liuzikai/wireless-charging-table/extra/JetsonNano-expansion-pinout.png

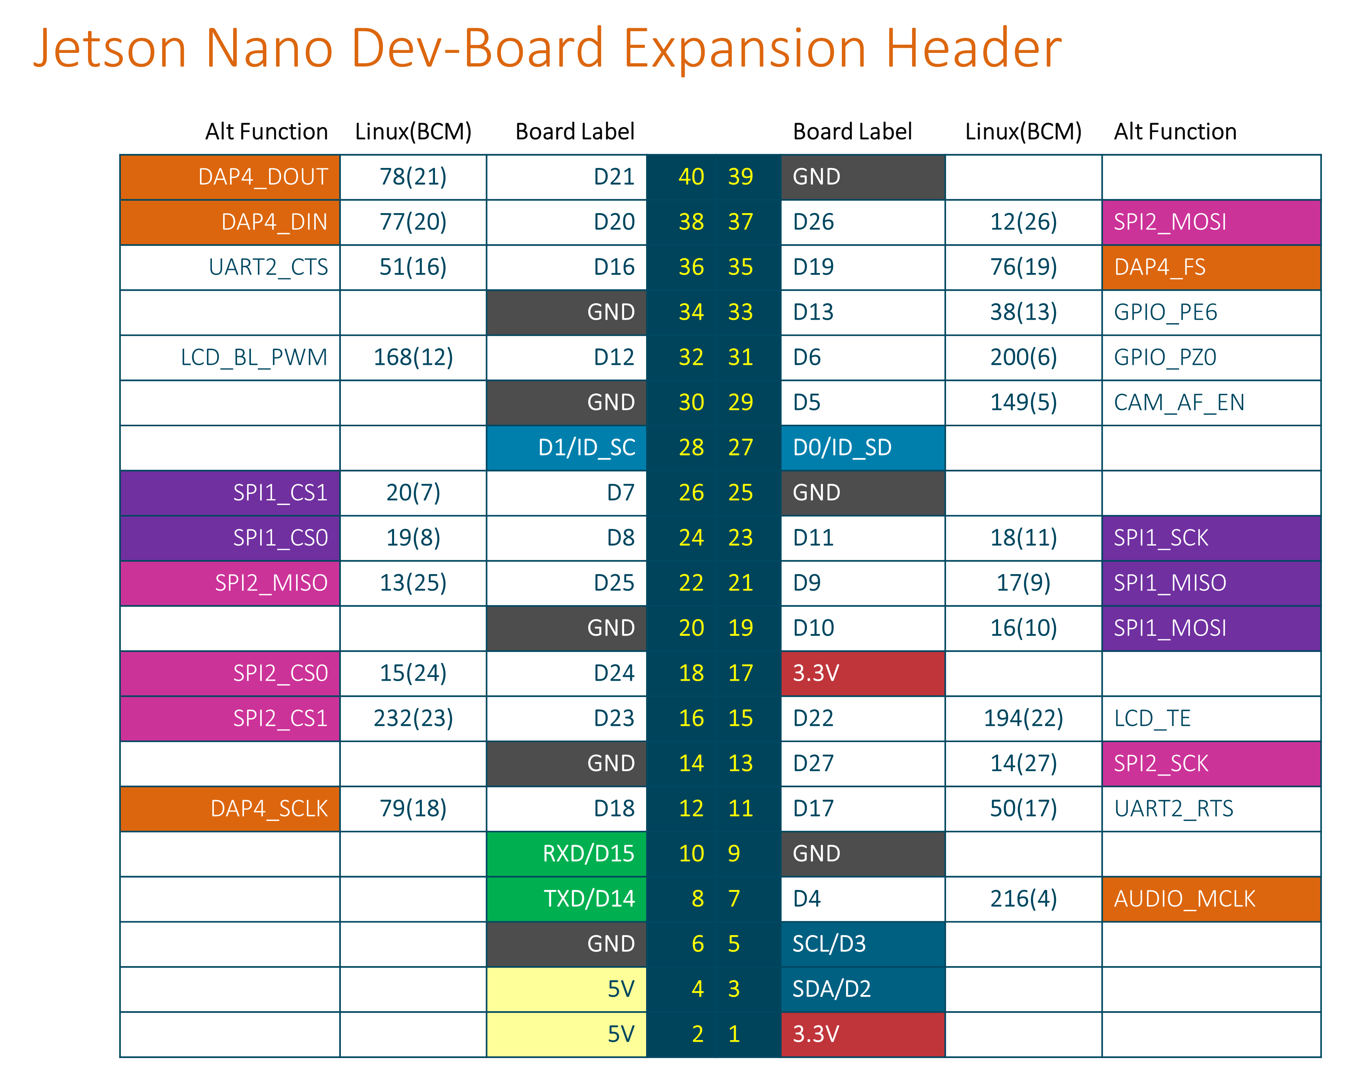
extra/JetsonNano-expansion-pinout.png
