liuzikai/wireless-charging-table/model/V1.0/Tensioner B-26^Tensioner B_Front Idler B_Gantry_VORON2 v2.4 Assembly - Final(2)_VORON2 v2.4 Assembly - Final.SLDPRT

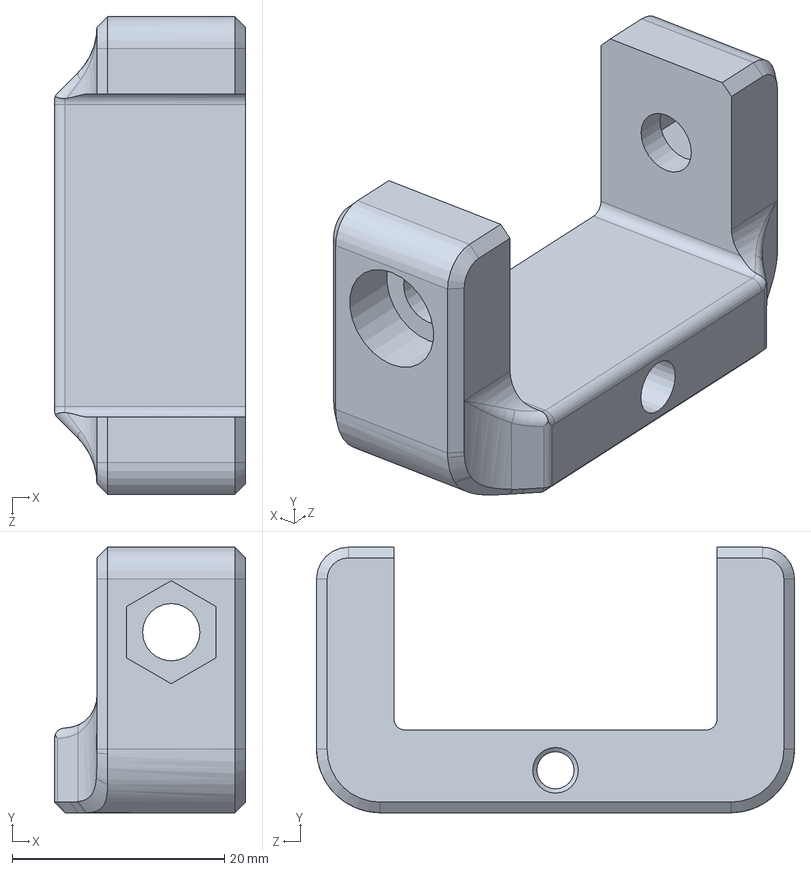
[picture p20: CAD file, 2022-02-23]
model/V1.0/Tensioner B-26^Tensioner B_Front Idler B_Gantry_VORON2 v2.4 Assembly - Final(2)_VORON2 v2.4 Assembly - Final.SLDPRT
18.0 x 25.0 x 45.0 mm
