liuzikai/wireless-charging-table/model/V1.0/NEMA17Thin.SLDASM

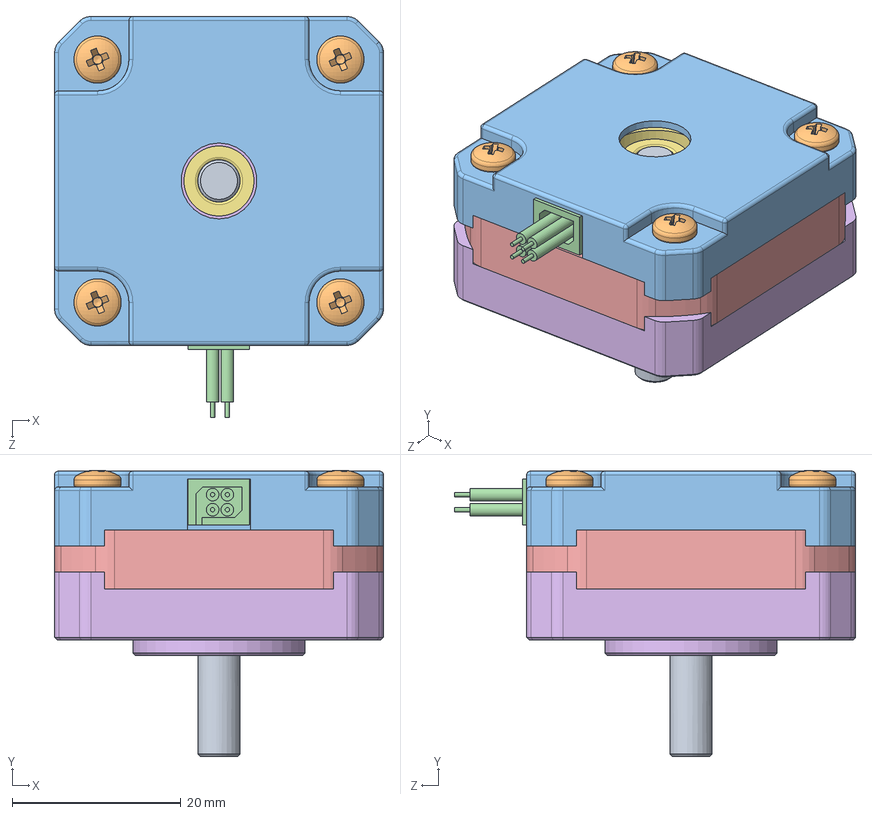
[picture p21: CAD file, 2022-02-23]
model/V1.0/NEMA17Thin.SLDASM
39.0 x 34.0 x 47.5 mm
41ME3991AL_Shaft.stp
M3 Screw.stp x 4
41ME3991AL_Back.stp
41ME3991AL_Cable.stp
41ME3991AL_Middle.stp
41ME3991AL_Front.stp
41ME3991AL_Roller.stp
