liuzikai/wireless-charging-table/model/V1.0/MGN9-390.SLDASM

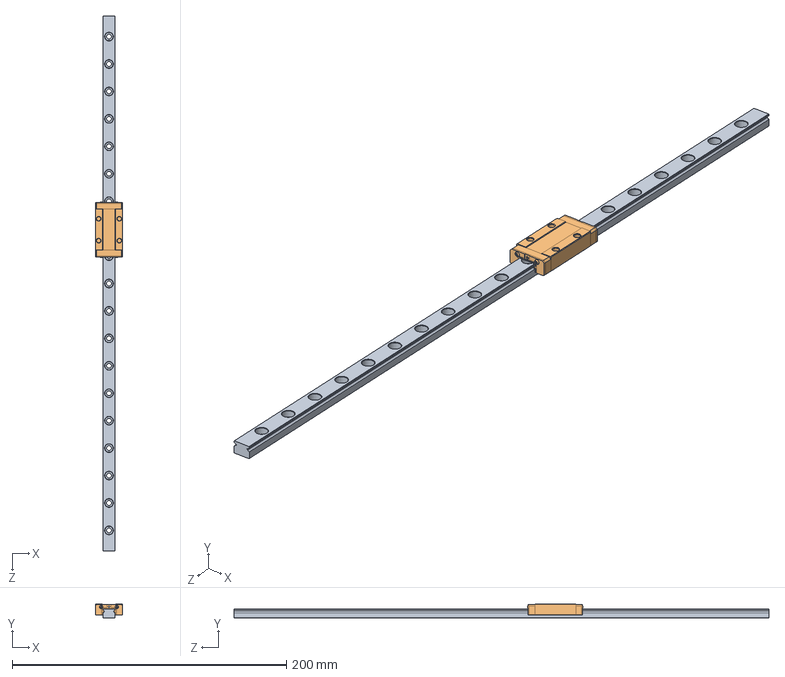
[picture p22: CAD file, 2022-02-23]
model/V1.0/MGN9-390.SLDASM
20.0 x 10.0 x 390.0 mm
MGN9
MGN9-H
