liuzikai/wireless-charging-table/model/V1.0/MGN9H.SLDASM

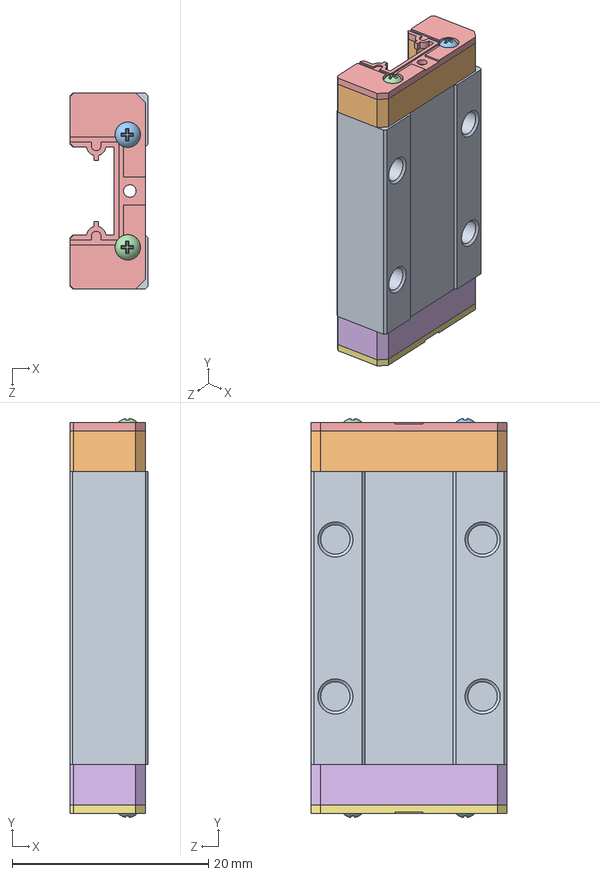
[picture p25: CAD file, 2022-02-23]
model/V1.0/MGN9H.SLDASM
8.00 x 40.7 x 20.0 mm
MGN9H - Carriage (9)^MGN9H
MGN9H - Carriage (1) (1)^MGN9H
MGN9H - Carriage (2) (1)^MGN9H
MGN9H - Carriage (3) (1)^MGN9H
MGN9H - Carriage (4) (1)^MGN9H
MGN9H - Carriage (5) (1)^MGN9H
MGN9H - Carriage (6) (1)^MGN9H
MGN9H - Carriage (7) (1)^MGN9H
MGN9H - Carriage (8) (1)^MGN9H
