liuzikai/wireless-charging-table/model/V1.0/XY Cable Chain Bridge - IGUS-58^XY Cable Chain Bridge - IGUS_XY Joint - Right_X Axis_Gantry_VORON2 v2.4 Assembly - Final(2)_VORON2 v2.4 Assembly - Final.SLDPRT

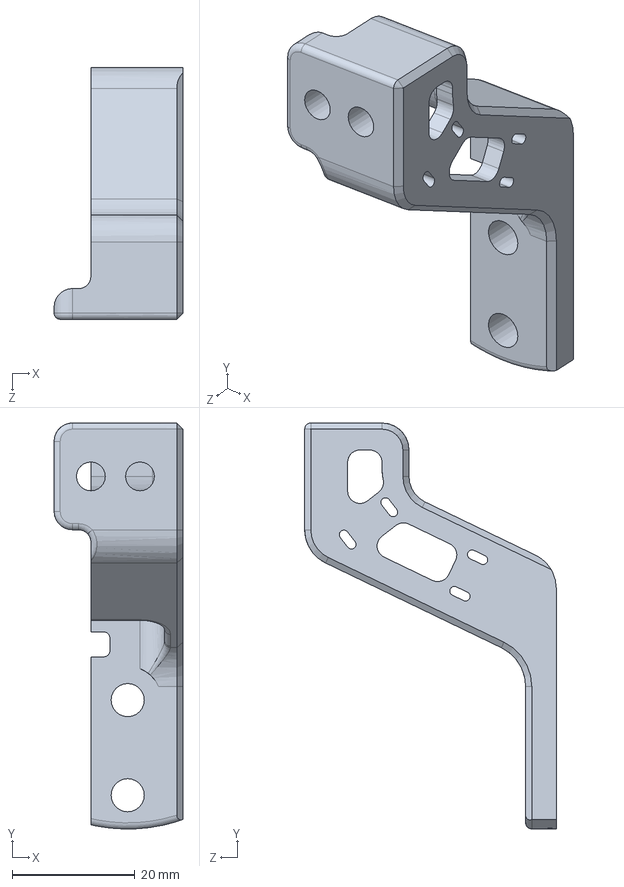
[picture p26: CAD file, 2022-02-23]
model/V1.0/XY Cable Chain Bridge - IGUS-58^XY Cable Chain Bridge - IGUS_XY Joint - Right_X Axis_Gantry_VORON2 v2.4 Assembly - Final(2)_VORON2 v2.4 Assembly - Final.SLDPRT
21.0 x 66.1 x 41.0 mm
