liuzikai/wireless-charging-table/model/V1.0/MGN12AssemXaxis.SLDASM

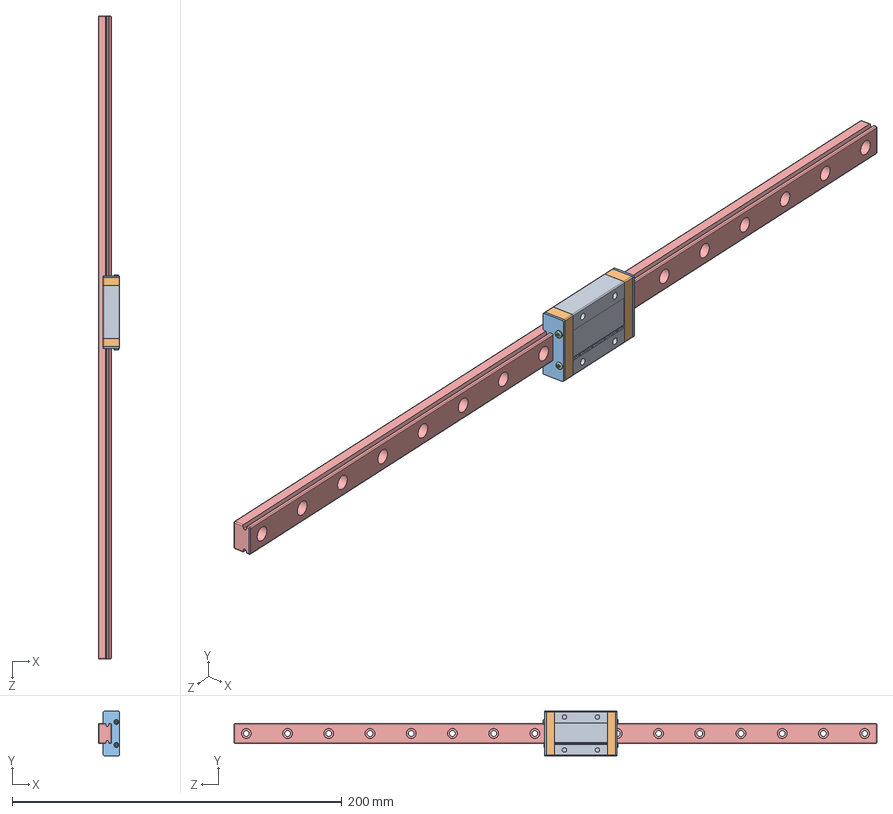
[picture p28: CAD file, 2022-02-23]
model/V1.0/MGN12AssemXaxis.SLDASM
13.0 x 27.0 x 390.0 mm
Main Block
Green End Cap x 2
Red End Cap x 2
Button M3x8 x 4
Rail 3850mm
