liuzikai/wireless-charging-table/model/V1.0/X Carriage Frame-35^X Carriage Frame_X Carriage_X Axis_Gantry_VORON2 v2.4 Assembly - Final(2)_VORON2 v2.4 Assembly - Final.SLDPRT

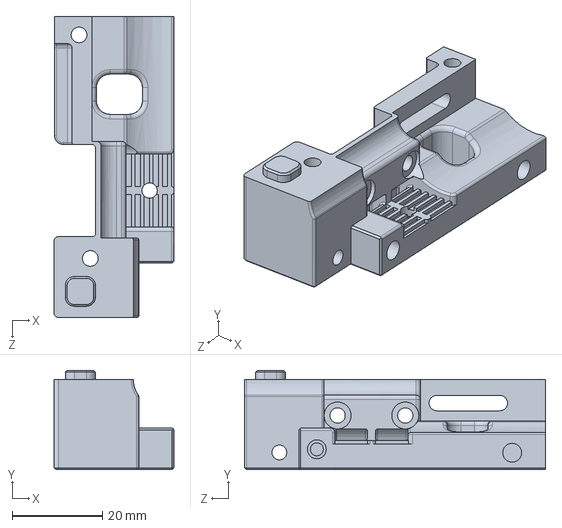
[picture p29: CAD file, 2022-02-23]
model/V1.0/X Carriage Frame-35^X Carriage Frame_X Carriage_X Axis_Gantry_VORON2 v2.4 Assembly - Final(2)_VORON2 v2.4 Assembly - Final.SLDPRT
26.6 x 22.0 x 66.8 mm
