liuzikai/wireless-charging-table/model/V1.0/Front Idler B Top^Front Idler B_Gantry_VORON2 v2.4 Assembly - Final(2)_VORON2 v2.4 Assembly - Final.SLDPRT

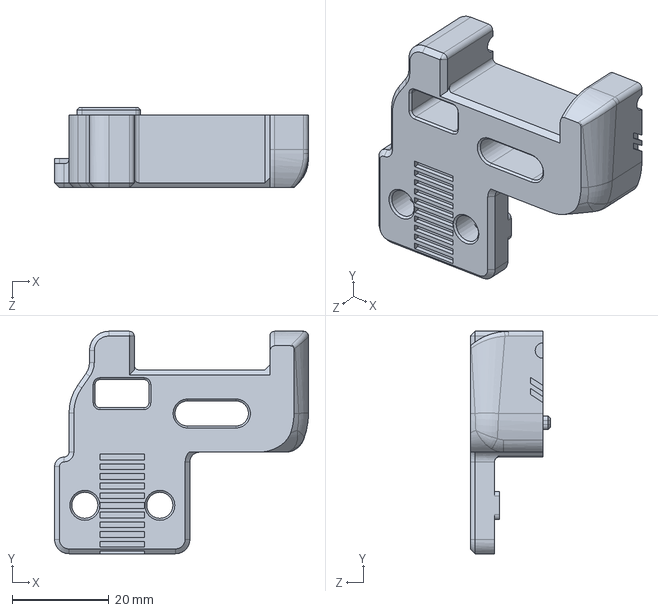
[picture p30: CAD file, 2022-02-23]
model/V1.0/Front Idler B Top^Front Idler B_Gantry_VORON2 v2.4 Assembly - Final(2)_VORON2 v2.4 Assembly - Final.SLDPRT
52.5 x 46.0 x 16.6 mm
