liuzikai/wireless-charging-table/model/V1.0/MGN9-120.SLDASM

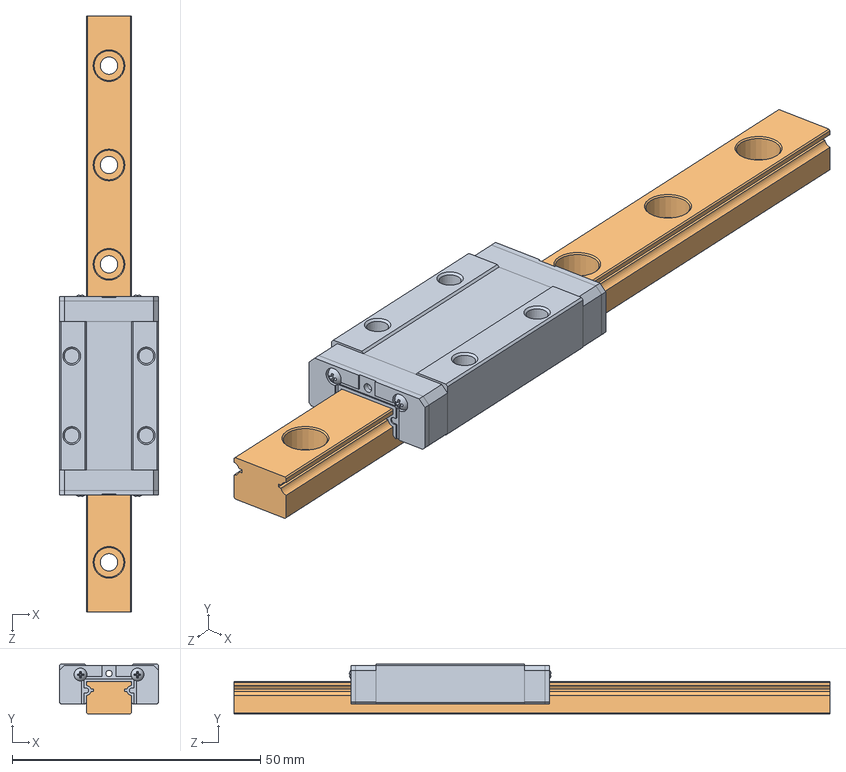
[picture p31: CAD file, 2022-02-23]
model/V1.0/MGN9-120.SLDASM
20.0 x 10.0 x 120.0 mm
MGN9-H
MGN9-120
