liuzikai/wireless-charging-table/model/V1.0/A Drive Frame-24^A Drive Frame_A Drive_Gantry_VORON2 v2.4 Assembly - Final(2)_VORON2 v2.4 Assembly - Final.SLDPRT

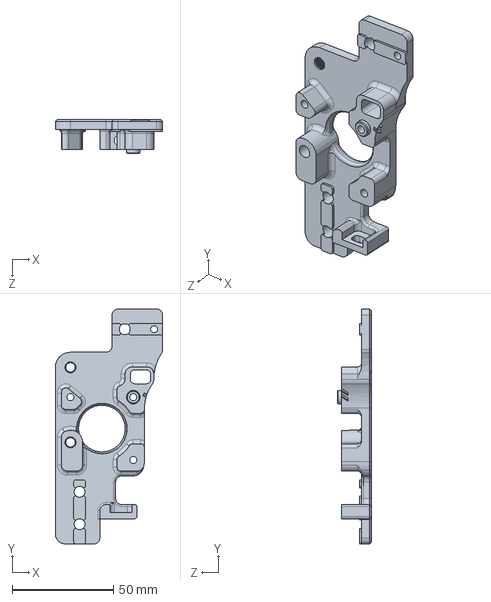
[picture p32: CAD file, 2022-02-23]
model/V1.0/A Drive Frame-24^A Drive Frame_A Drive_Gantry_VORON2 v2.4 Assembly - Final(2)_VORON2 v2.4 Assembly - Final.SLDPRT
53.0 x 116.0 x 17.0 mm
