liuzikai/wireless-charging-table/model/V1.0/XY Joint - Right-63^XY Joint - Right_X Axis_Gantry_VORON2 v2.4 Assembly - Final(2)_VORON2 v2.4 Assembly - Final.SLDPRT

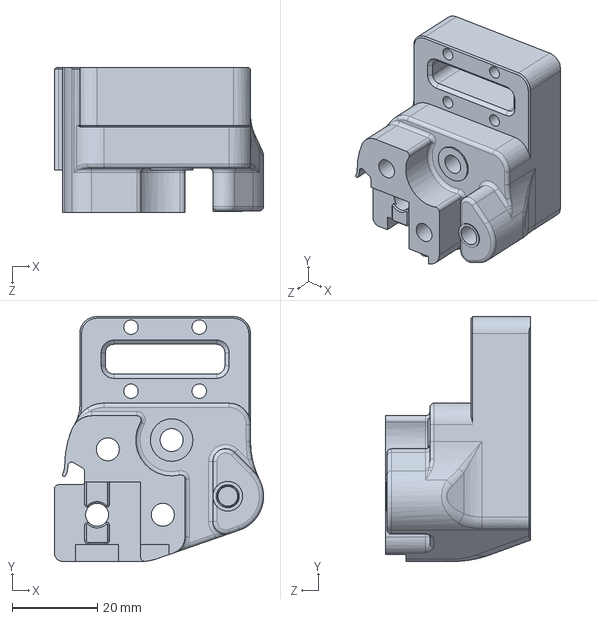
[picture p34: CAD file, 2022-02-23]
model/V1.0/XY Joint - Right-63^XY Joint - Right_X Axis_Gantry_VORON2 v2.4 Assembly - Final(2)_VORON2 v2.4 Assembly - Final.SLDPRT
49.0 x 57.4 x 34.0 mm
