liuzikai/wireless-charging-table/model/V1.0/cable cover^A Drive_Gantry_VORON2 v2.4 Assembly - Final(2)_VORON2 v2.4 Assembly - Final.SLDPRT

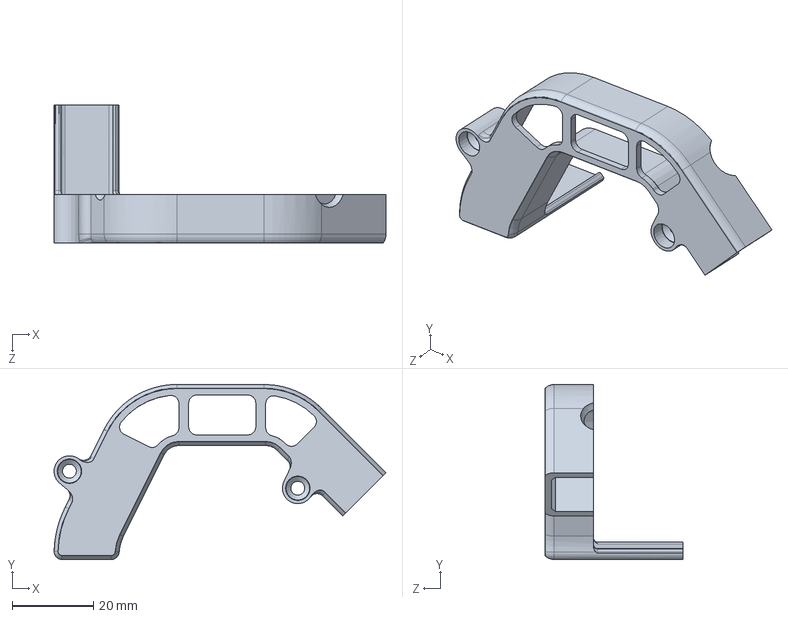
[picture p35: CAD file, 2022-02-23]
model/V1.0/cable cover^A Drive_Gantry_VORON2 v2.4 Assembly - Final(2)_VORON2 v2.4 Assembly - Final.SLDPRT
81.5 x 43.0 x 34.0 mm
