liuzikai/wireless-charging-table/model/V1.0/B Drive Frame (1)^B Drive_Gantry_VORON2 v2.4 Assembly - Final(2)_VORON2 v2.4 Assembly - Final.SLDPRT

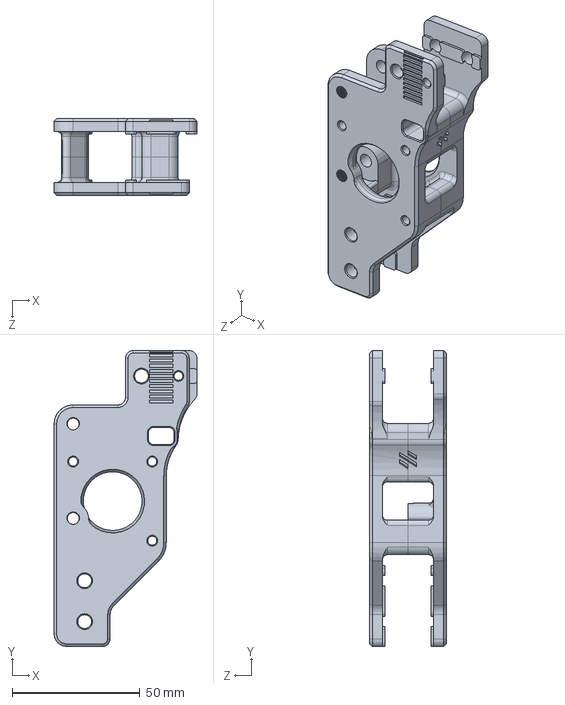
[picture p36: CAD file, 2022-02-23]
model/V1.0/B Drive Frame (1)^B Drive_Gantry_VORON2 v2.4 Assembly - Final(2)_VORON2 v2.4 Assembly - Final.SLDPRT
56.0 x 116.0 x 30.0 mm
