liuzikai/wireless-charging-table/model/V1.0/Belt Clamp_1-34^Belt Clamp_1_X Carriage Frame_X Carriage_X Axis_Gantry_VORON2 v2.4 Assembly - Final(2)_VORON2 v2.4 Assembly - Final.SLDPRT

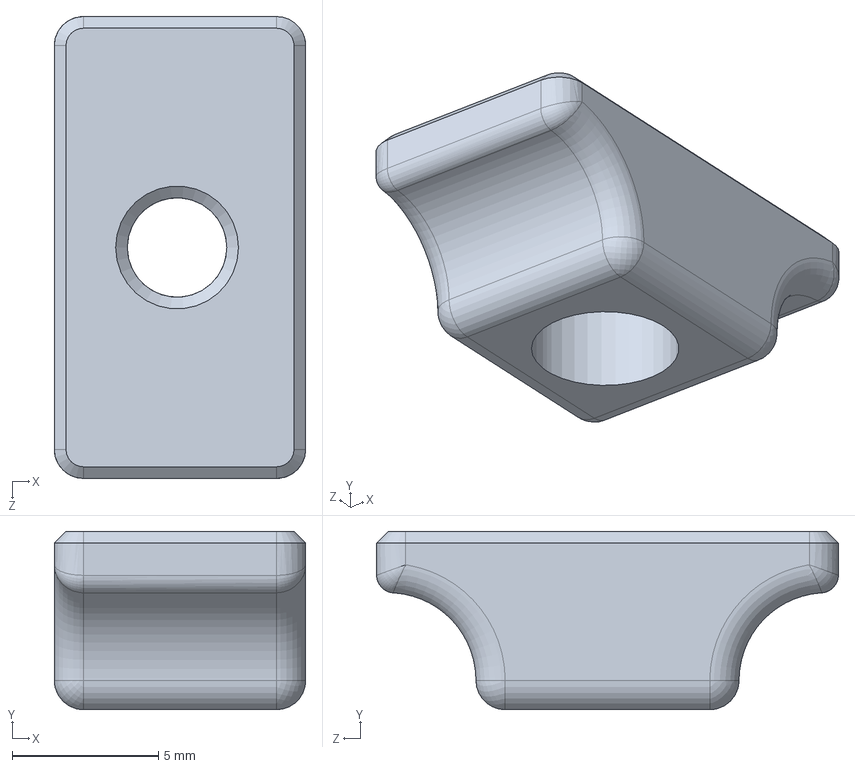
[picture p37: CAD file, 2022-02-23]
model/V1.0/Belt Clamp_1-34^Belt Clamp_1_X Carriage Frame_X Carriage_X Axis_Gantry_VORON2 v2.4 Assembly - Final(2)_VORON2 v2.4 Assembly - Final.SLDPRT
8.60 x 6.10 x 15.8 mm
