liuzikai/wireless-charging-table/model/V1.0/GT2 20T 6mm^B Drive_Gantry_VORON2 v2.4 Assembly - Final(2)_VORON2 v2.4 Assembly - Final.SLDPRT

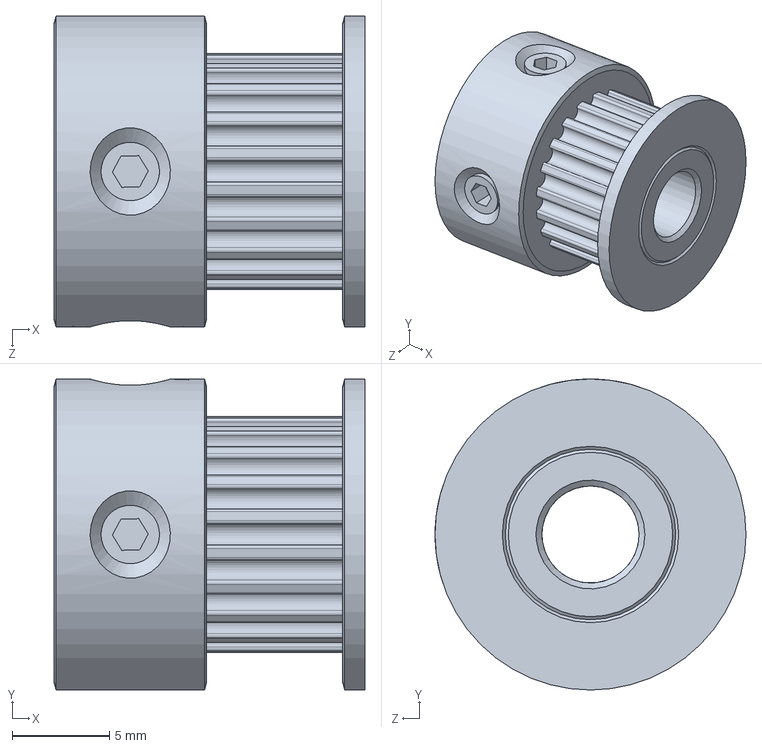
[picture p38: CAD file, 2022-02-23]
model/V1.0/GT2 20T 6mm^B Drive_Gantry_VORON2 v2.4 Assembly - Final(2)_VORON2 v2.4 Assembly - Final.SLDPRT
16.0 x 16.0 x 16.0 mm
