liuzikai/wireless-charging-table/model/V1.0/NEMA17 Black^B Drive_Gantry_VORON2 v2.4 Assembly - Final(2)_VORON2 v2.4 Assembly - Final.SLDPRT

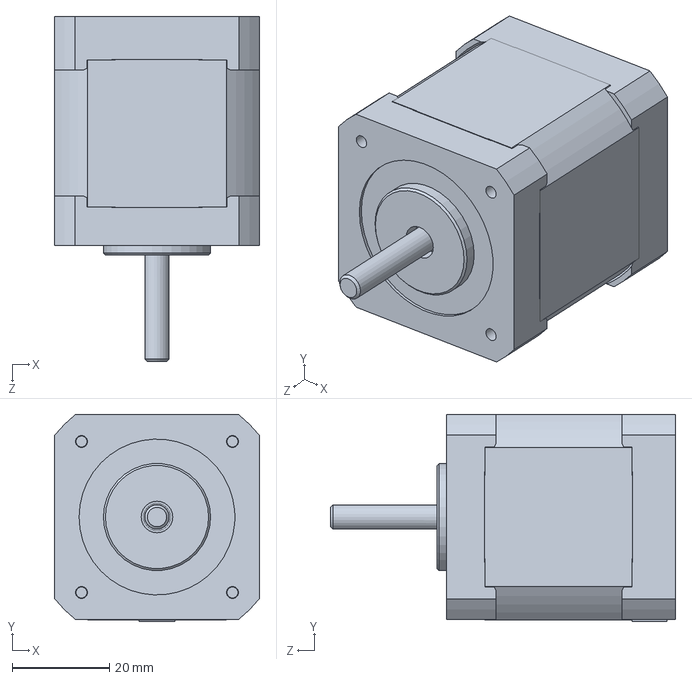
[picture p39: CAD file, 2022-02-23]
model/V1.0/NEMA17 Black^B Drive_Gantry_VORON2 v2.4 Assembly - Final(2)_VORON2 v2.4 Assembly - Final.SLDPRT
42.2 x 42.6 x 70.8 mm
