liuzikai/wireless-charging-table/model/V1.0/F695 ZZ (1)^Idler Assembly (1)_1_XY Joint - Right_X Axis_Gantry_VORON2 v2.4 Assembly - Final(2)_VORON2 v2.4 Assembly - Final.SLDPRT

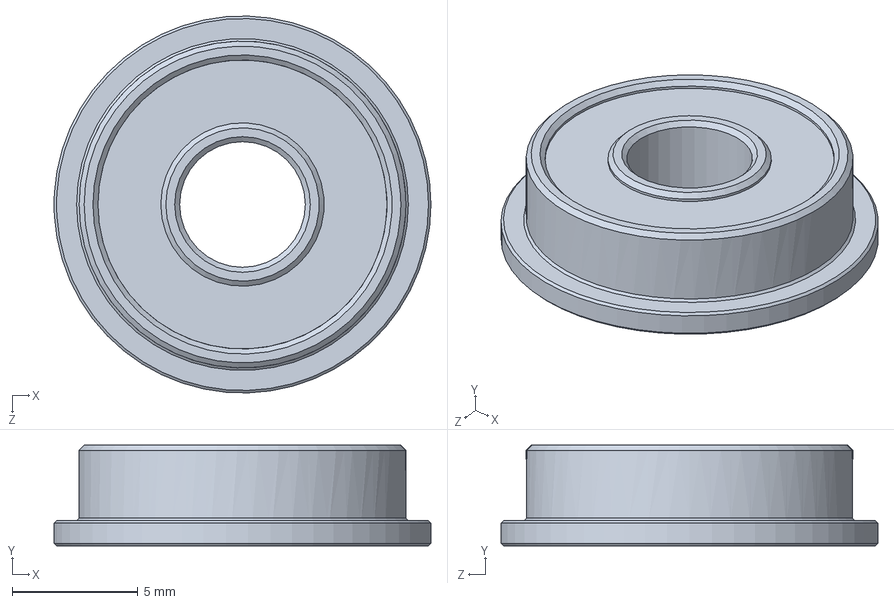
[picture p40: CAD file, 2022-02-23]
model/V1.0/F695 ZZ (1)^Idler Assembly (1)_1_XY Joint - Right_X Axis_Gantry_VORON2 v2.4 Assembly - Final(2)_VORON2 v2.4 Assembly - Final.SLDPRT
15.0 x 4.00 x 15.0 mm
