liuzikai/wireless-charging-table/model/V1.0/IEC320-C14.SLDASM

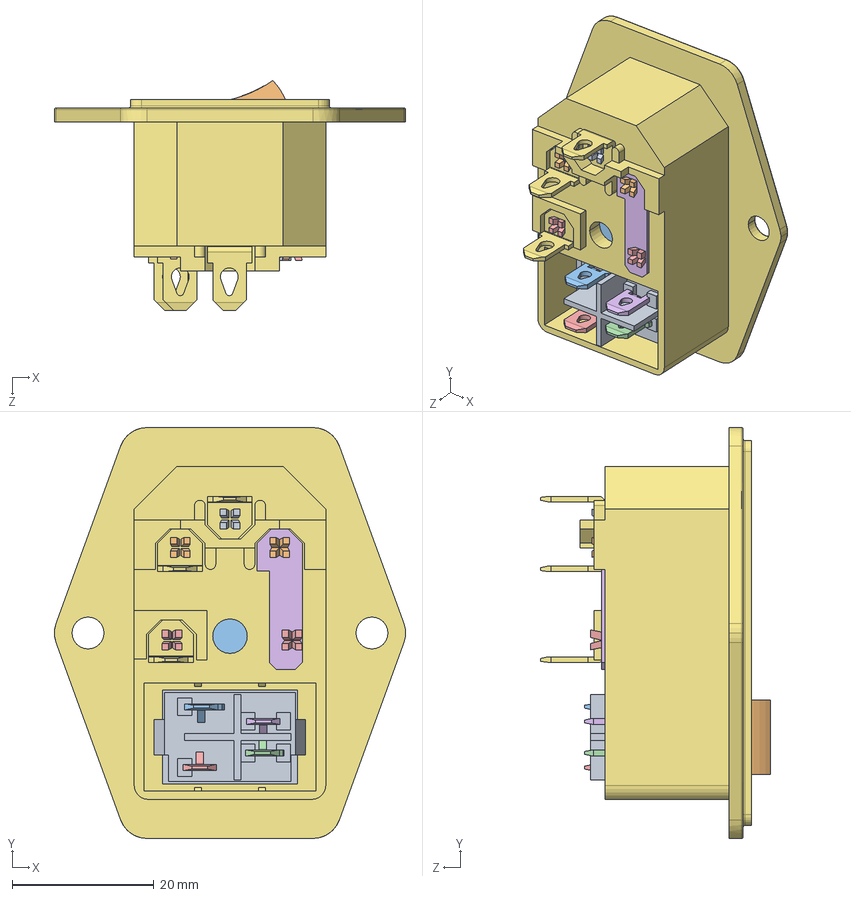
[picture p41: CAD file, 2022-02-23]
model/V1.0/IEC320-C14.SLDASM
49.5 x 57.9 x 32.4 mm
switch_base.STEP
rocker.STEP
sm_tab_type1a.STEP
sm_tab_type1b.STEP
sm_tab_type2a.STEP
sm_tab_type2b.STEP
ilpm_case.STEP
fuse_clip_set.STEP
blade_15.STEP
blade_12.STEP x 2
fuse-holder.STEP
fuse.STEP
spot.STEP x 2
stamped_cond.STEP
correct_big_tab.STEP x 3
