liuzikai/wireless-charging-table/model/V1.0/Z Belt Clamp Upper^Front Idler B_Gantry_VORON2 v2.4 Assembly - Final(2)_VORON2 v2.4 Assembly - Final.SLDPRT

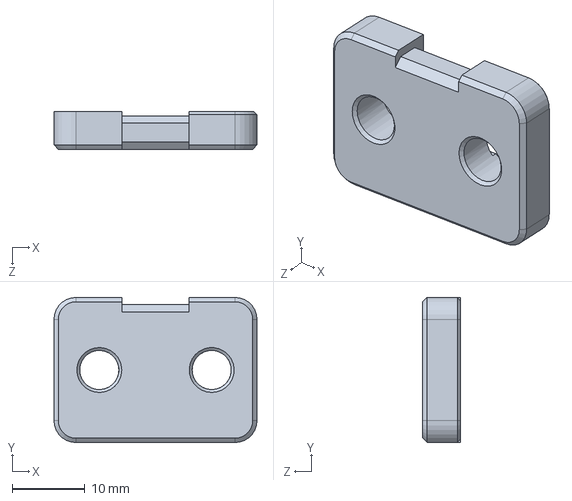
[picture p42: CAD file, 2022-02-23]
model/V1.0/Z Belt Clamp Upper^Front Idler B_Gantry_VORON2 v2.4 Assembly - Final(2)_VORON2 v2.4 Assembly - Final.SLDPRT
28.0 x 20.0 x 5.20 mm
