liuzikai/wireless-charging-table/model/V1.0/Main Block.SLDPRT

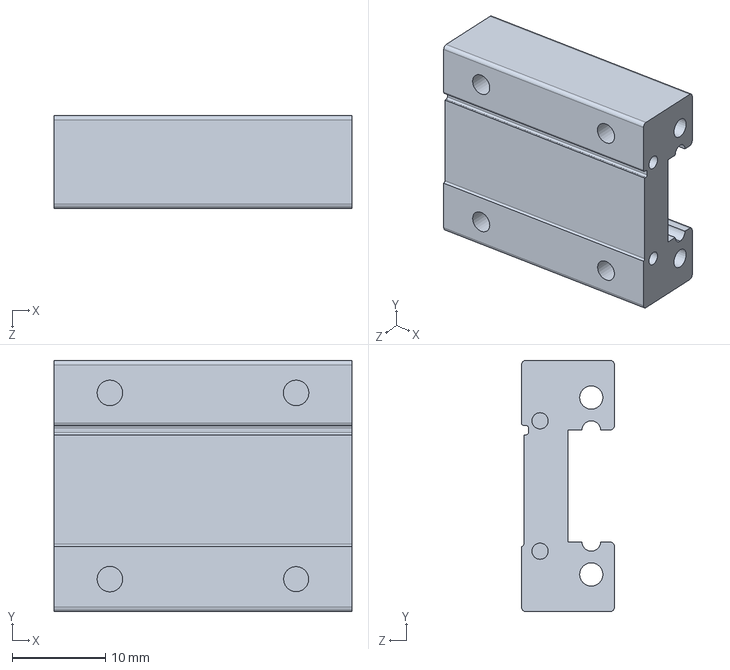
[picture p44: CAD file, 2022-02-23]
model/V1.0/Main Block.SLDPRT
32.0 x 27.0 x 10.0 mm
