liuzikai/wireless-charging-table/model/V1.0/GT2 20T Idler Gates v2^XY Joint - Right_X Axis_Gantry_VORON2 v2.4 Assembly - Final(2)_VORON2 v2.4 Assembly - Final.SLDPRT

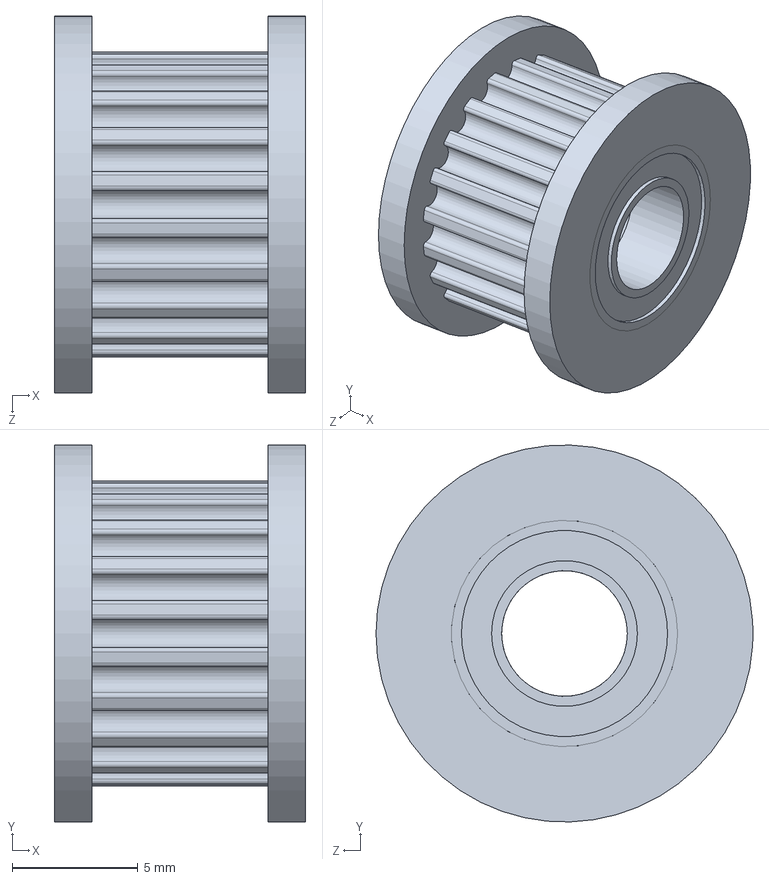
[picture p47: CAD file, 2022-02-23]
model/V1.0/GT2 20T Idler Gates v2^XY Joint - Right_X Axis_Gantry_VORON2 v2.4 Assembly - Final(2)_VORON2 v2.4 Assembly - Final.SLDPRT
10.0 x 15.0 x 15.0 mm
