liuzikai/wireless-charging-table/model/V1.0/Front Idler A Bottom (1)^Front Idler A_Gantry_VORON2 v2.4 Assembly - Final(2)_VORON2 v2.4 Assembly - Final.SLDPRT

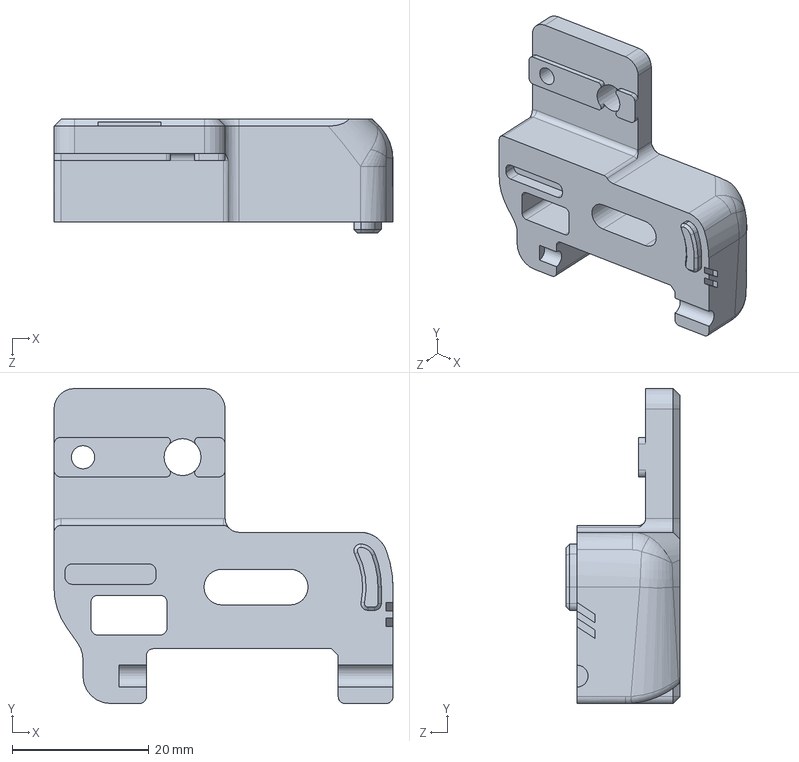
[picture p48: CAD file, 2022-02-23]
model/V1.0/Front Idler A Bottom (1)^Front Idler A_Gantry_VORON2 v2.4 Assembly - Final(2)_VORON2 v2.4 Assembly - Final.SLDPRT
49.5 x 46.0 x 16.6 mm
