liuzikai/wireless-charging-table/model/V1.0/MotorMount.sldprt

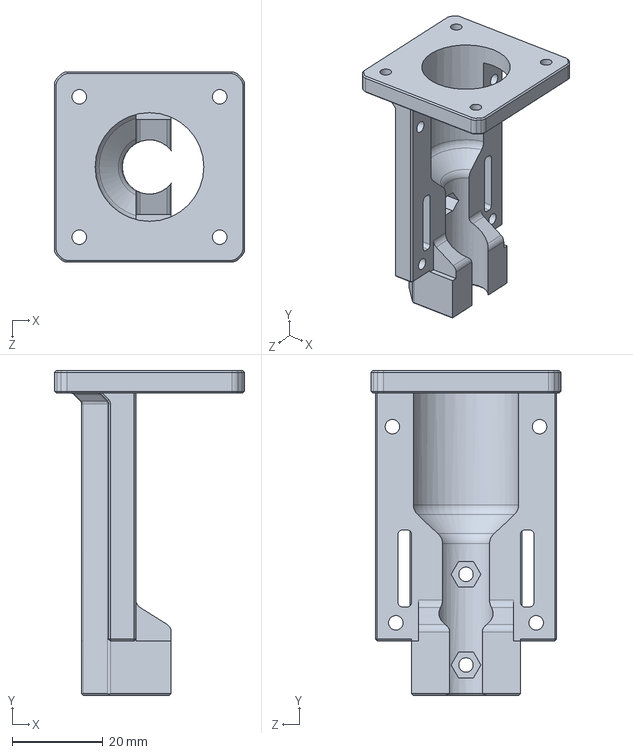
[picture p49: CAD file, 2022-02-23]
model/V1.0/MotorMount.sldprt
42.0 x 71.8 x 42.0 mm
