liuzikai/wireless-charging-table/model/V1.0/CoilBase.SLDPRT

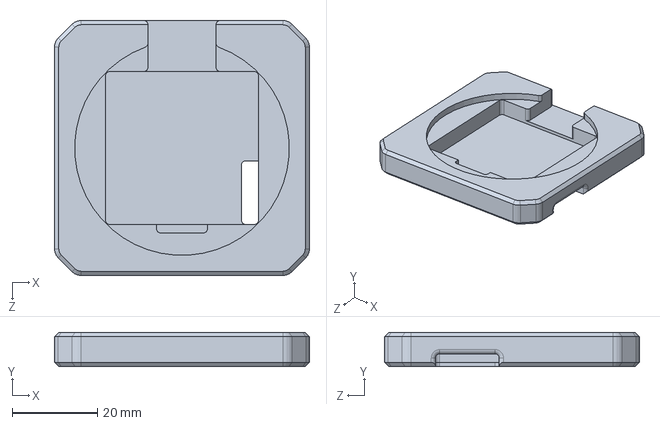
[picture p50: CAD file, 2022-02-23]
model/V1.0/CoilBase.SLDPRT
60.0 x 8.00 x 60.0 mm
