liuzikai/wireless-charging-table/model/V1.0/GlassSheetHolderCorner.SLDPRT

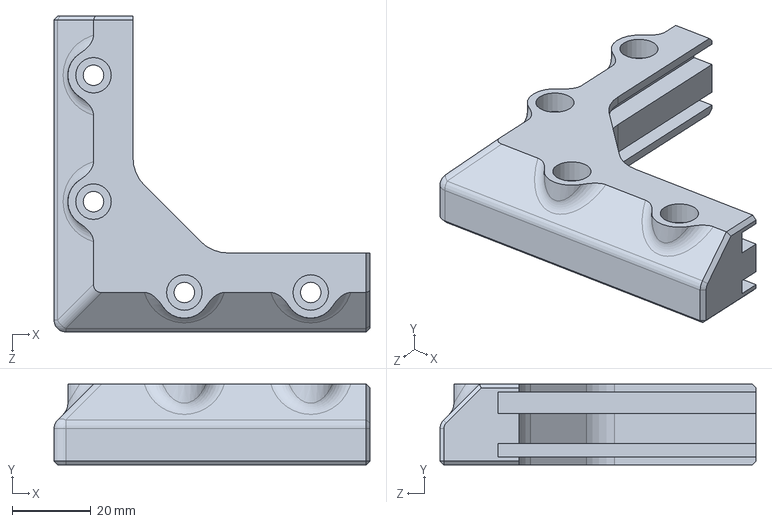
[picture p51: CAD file, 2022-02-23]
model/V1.0/GlassSheetHolderCorner.SLDPRT
80.0 x 20.5 x 80.0 mm
