liuzikai/wireless-charging-table/model/V1.0/GlassSheet5mm.SLDPRT

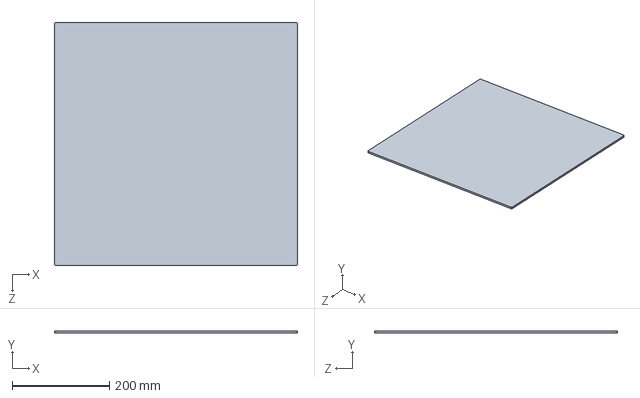
[picture p52: CAD file, 2022-02-23]
model/V1.0/GlassSheet5mm.SLDPRT
500.0 x 5.00 x 500.0 mm
