liuzikai/wireless-charging-table/model/V1.0/PowerCover.sldprt

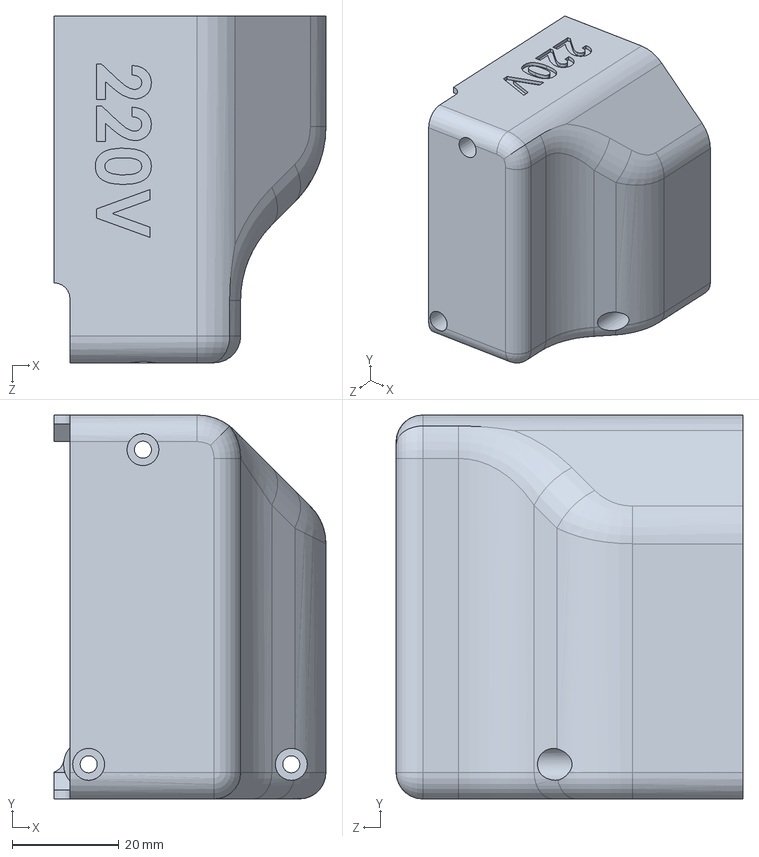
[picture p53: CAD file, 2022-02-23]
model/V1.0/PowerCover.sldprt
51.0 x 72.0 x 65.0 mm
