liuzikai/wireless-charging-table/model/V1.0/Green End Cap.SLDPRT

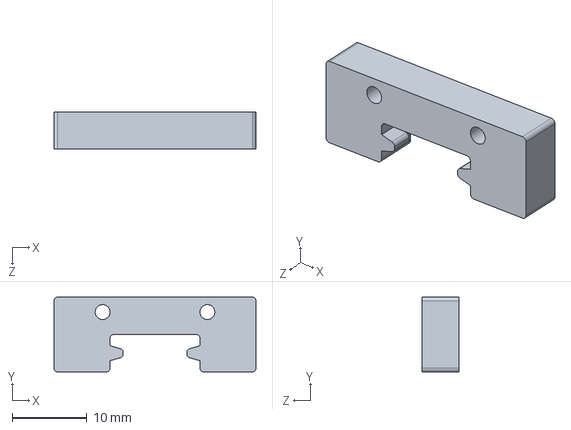
[picture p54: CAD file, 2022-02-23]
model/V1.0/Green End Cap.SLDPRT
27.0 x 10.0 x 5.00 mm
