liuzikai/wireless-charging-table/model/V1.0/Button M3x8.SLDPRT

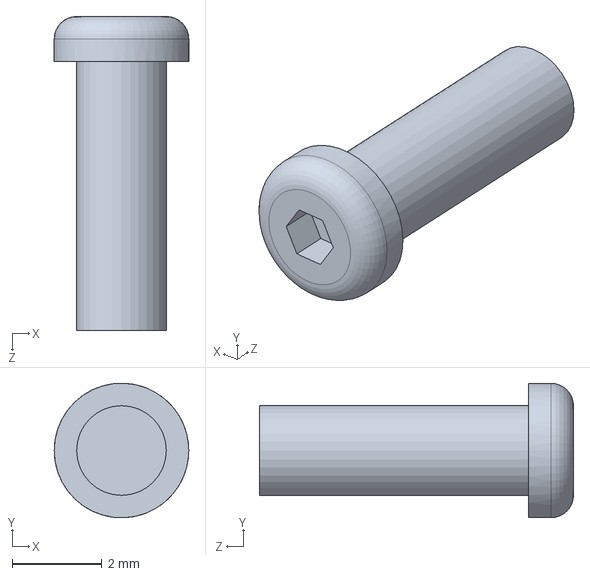
[picture p55: CAD file, 2022-02-23]
model/V1.0/Button M3x8.SLDPRT
3.00 x 3.00 x 7.00 mm
