liuzikai/wireless-charging-table/model/V1.0/Red End Cap.SLDPRT

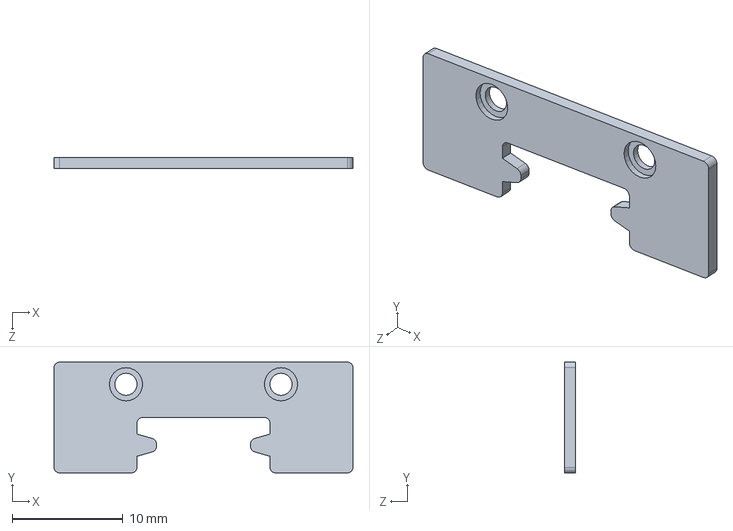
[picture p56: CAD file, 2022-02-23]
model/V1.0/Red End Cap.SLDPRT
27.0 x 10.0 x 1.00 mm
