liuzikai/wireless-charging-table/model/V1.0/ALP2020_330.SLDPRT

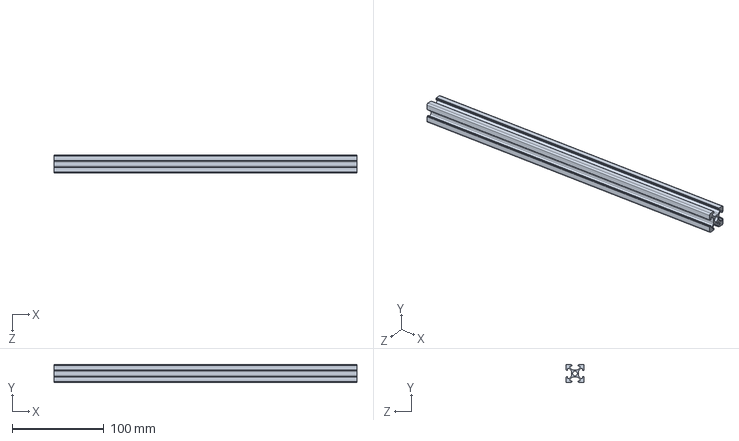
[picture p57: CAD file, 2022-02-23]
model/V1.0/ALP2020_330.SLDPRT
330.0 x 20.0 x 20.0 mm
