liuzikai/wireless-charging-table/model/V1.0/FootCorner.SLDPRT

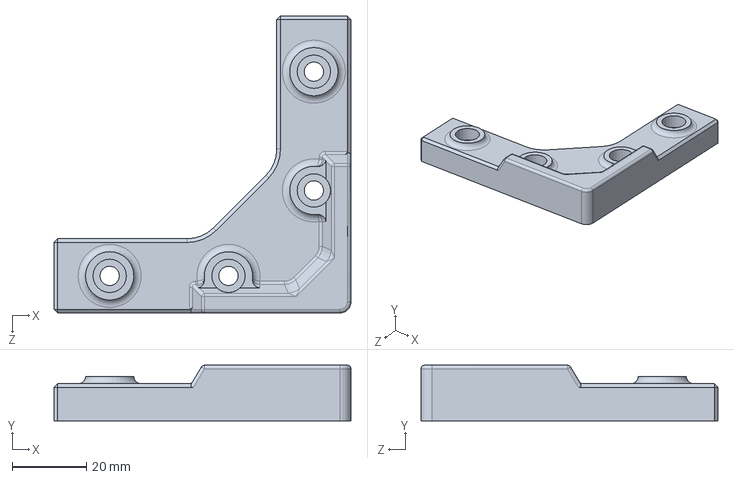
[picture p58: CAD file, 2022-02-23]
model/V1.0/FootCorner.SLDPRT
80.0 x 15.0 x 80.0 mm
