liuzikai/wireless-charging-table/model/V1.0/MagnetHead.SLDPRT

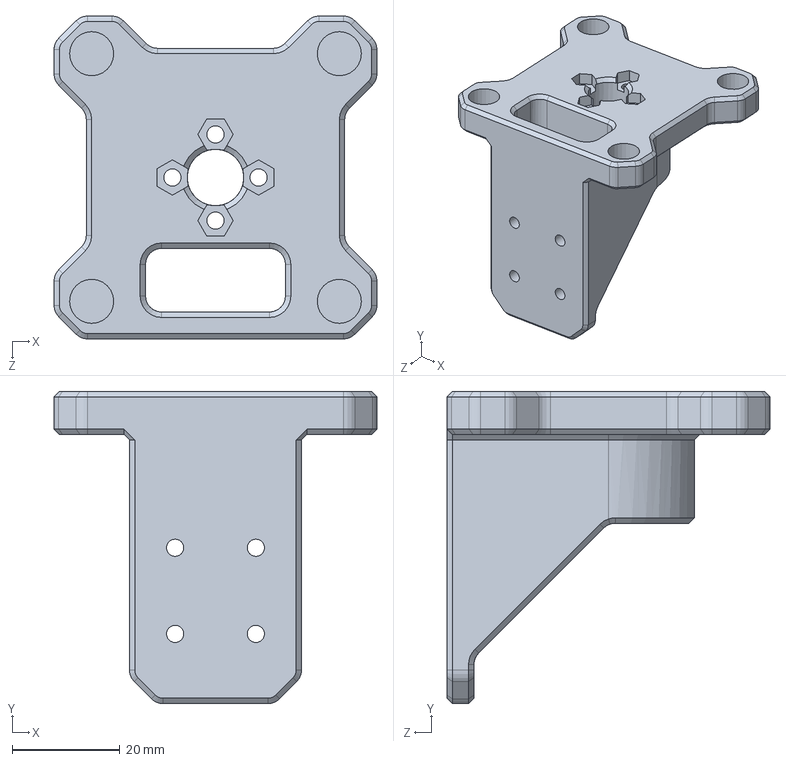
[picture p59: CAD file, 2022-02-23]
model/V1.0/MagnetHead.SLDPRT
60.0 x 58.0 x 60.0 mm
