liuzikai/wireless-charging-table/model/V1.0/D20L25 Jaw Coupler v5.step

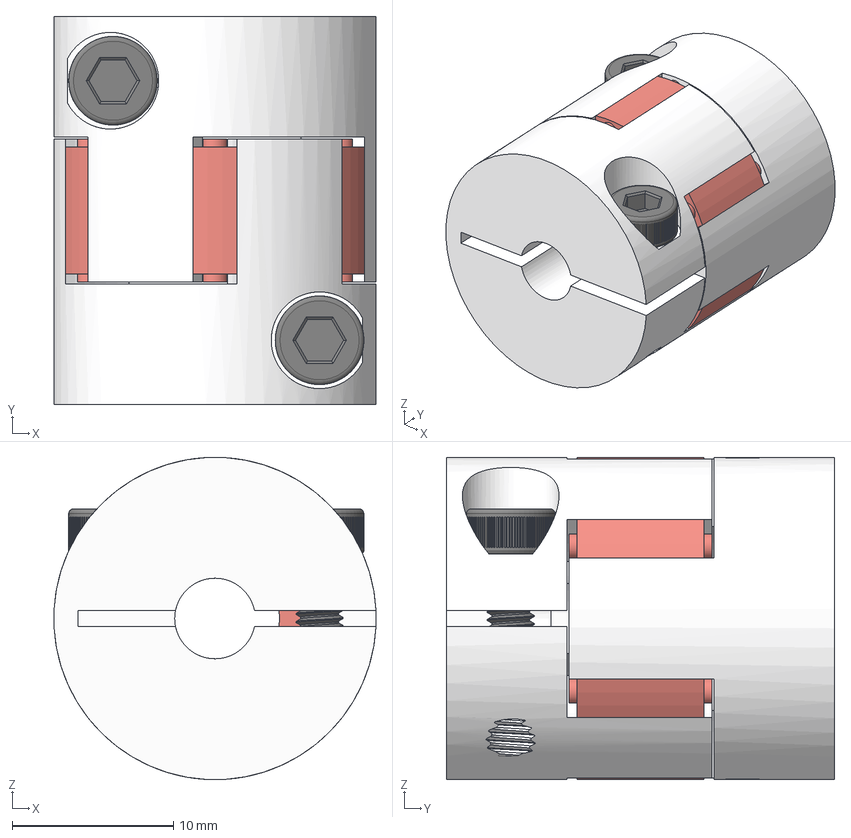
[picture p60: CAD file, 2022-02-23]
model/V1.0/D20L25 Jaw Coupler v5.step
20.0 x 24.1 x 20.0 mm
5mm Shaft Side
8mm Shaft Side
Insert
M3x10 mm Hex Screw x 2
