liuzikai/wireless-charging-table/model/V1.0/GlassSheetHolderCorner2.SLDPRT

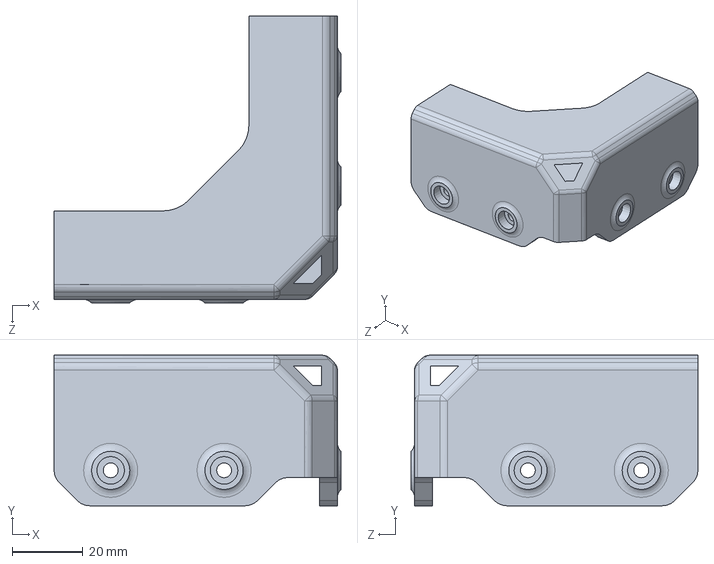
[picture p61: CAD file, 2022-02-23]
model/V1.0/GlassSheetHolderCorner2.SLDPRT
81.0 x 42.5 x 81.0 mm
