liuzikai/wireless-charging-table/model/V1.0/Rail 3850mm.SLDPRT

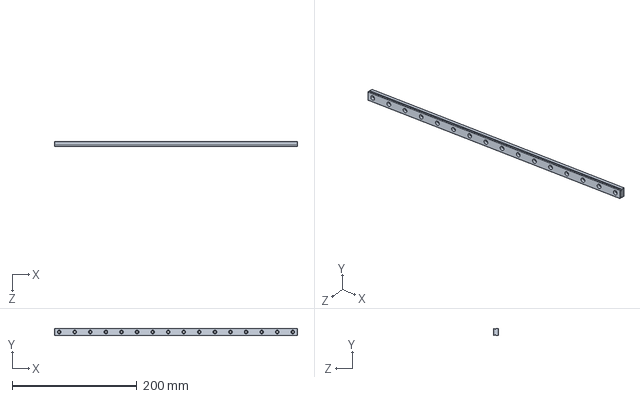
[picture p62: CAD file, 2022-02-23]
model/V1.0/Rail 3850mm.SLDPRT
390.0 x 12.0 x 8.00 mm
