liuzikai/wireless-charging-table/model/V1.0/ALP2020_460.SLDPRT

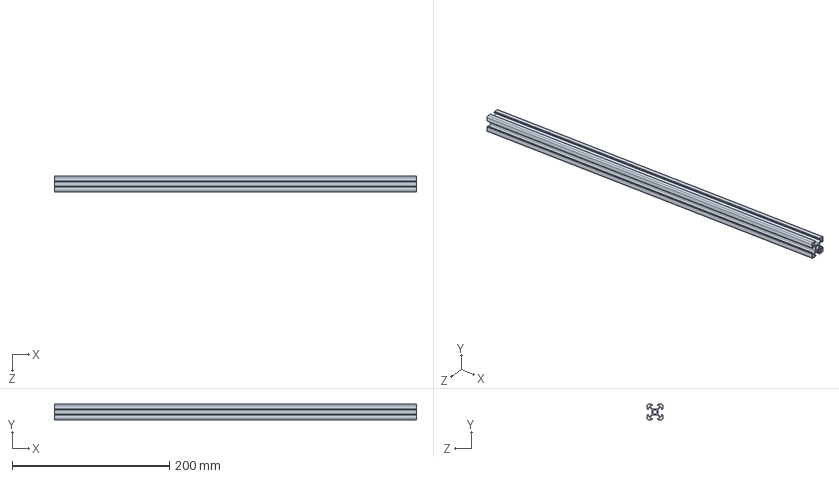
[picture p63: CAD file, 2022-02-23]
model/V1.0/ALP2020_460.SLDPRT
460.0 x 20.0 x 20.0 mm
