liuzikai/wireless-charging-table/model/V1.0/GlassSheetHolderSide.SLDPRT

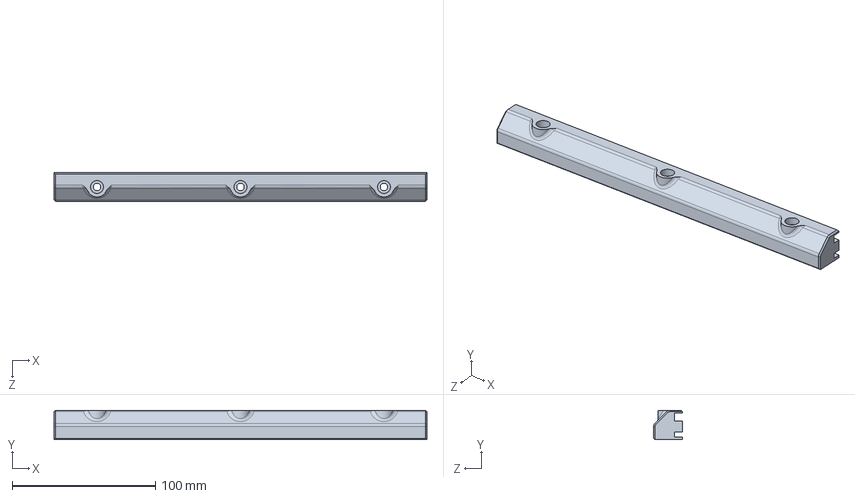
[picture p64: CAD file, 2022-02-23]
model/V1.0/GlassSheetHolderSide.SLDPRT
260.0 x 20.5 x 20.0 mm
