liuzikai/wireless-charging-table/model/V1.0/Belt1-5.sldprt

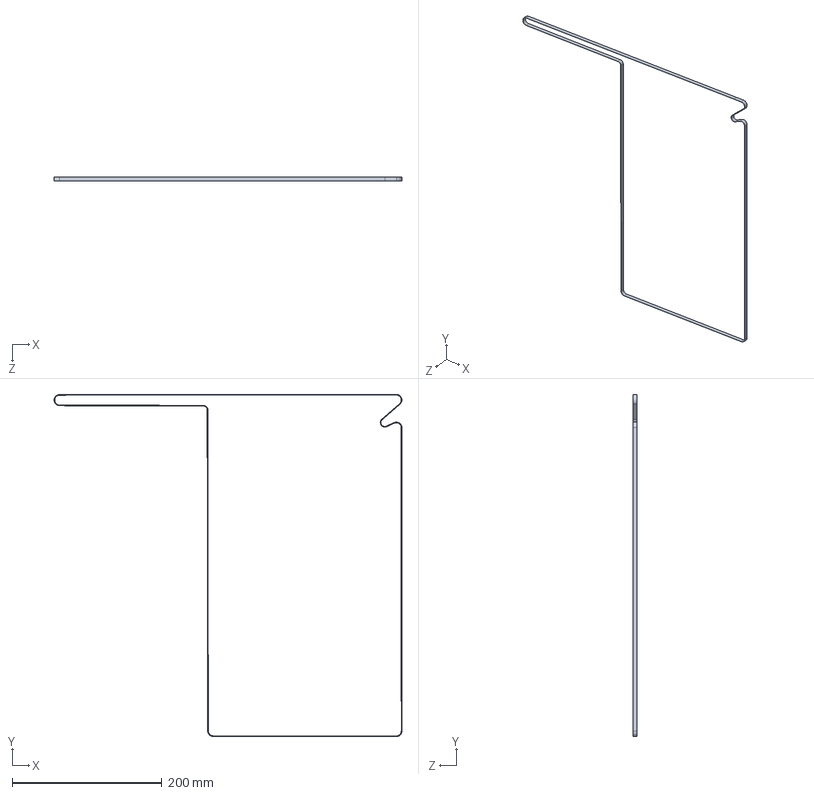
[picture p65: CAD file, 2022-02-23]
model/V1.0/Belt1-5.sldprt
465.0 x 457.4 x 6.00 mm
