liuzikai/wireless-charging-table/model/V1.0/PowerSwitchMount.sldprt

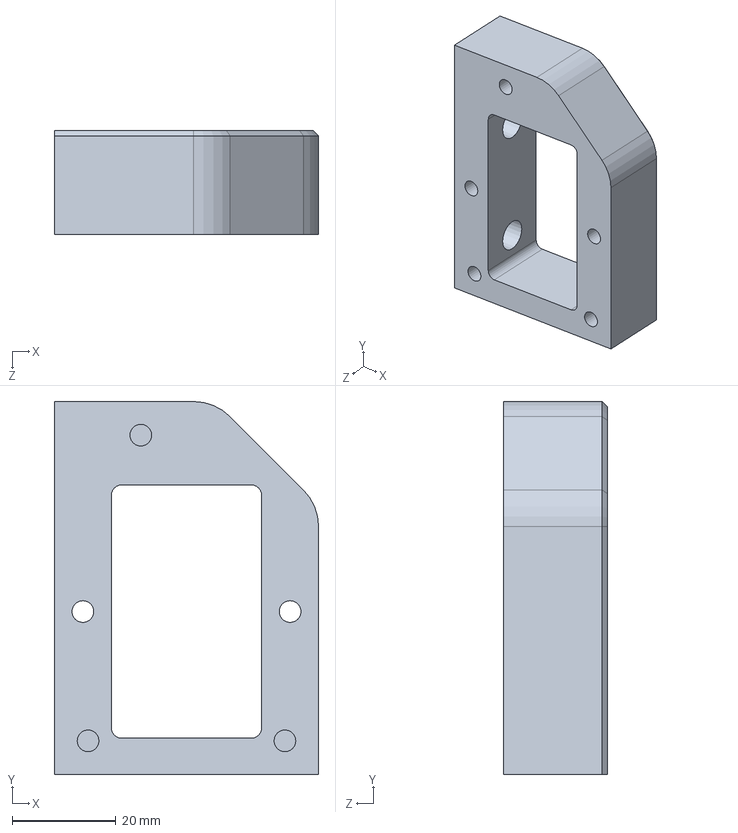
[picture p66: CAD file, 2022-02-23]
model/V1.0/PowerSwitchMount.sldprt
51.0 x 72.0 x 20.0 mm
