liuzikai/wireless-charging-table/model/V1.0/BottomCorner.sldprt

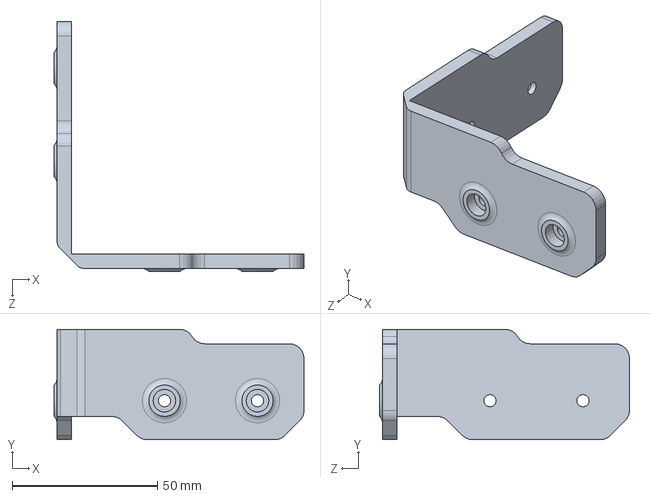
[picture p67: CAD file, 2022-02-23]
model/V1.0/BottomCorner.sldprt
86.0 x 38.0 x 86.0 mm
