liuzikai/wireless-charging-table/model/V1.0/Belt2-4.sldprt

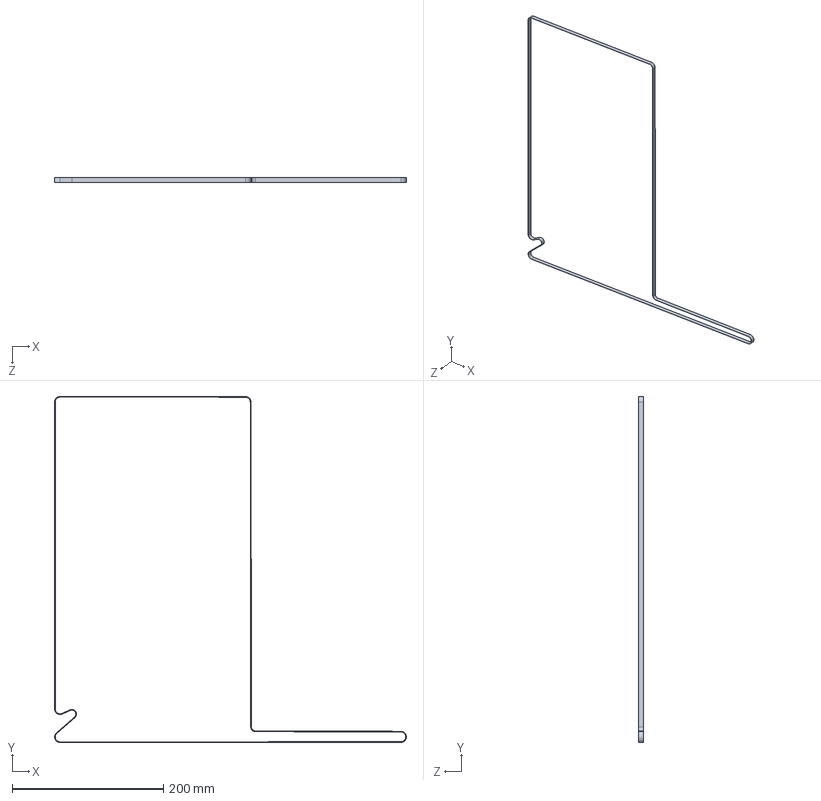
[picture p68: CAD file, 2022-02-23]
model/V1.0/Belt2-4.sldprt
464.8 x 457.1 x 6.00 mm
