liuzikai/wireless-charging-table/model/V1.0/camera.SLDPRT

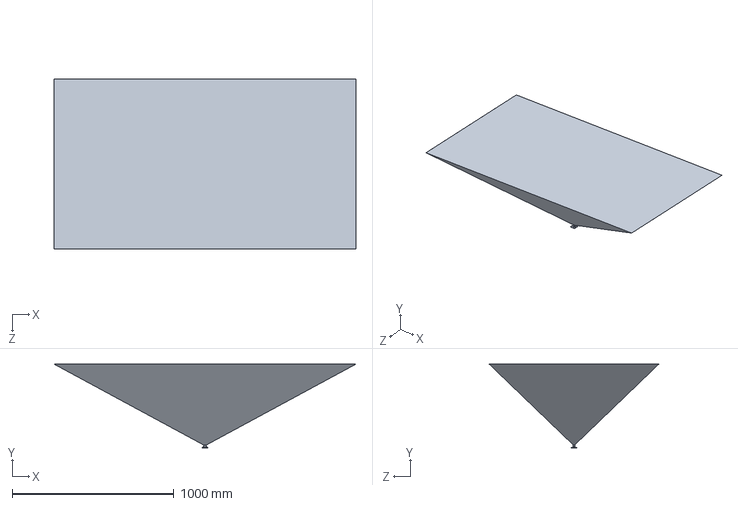
[picture p69: CAD file, 2022-02-23]
model/V1.0/camera.SLDPRT
1868.7 x 518.6 x 1051.0 mm
