liuzikai/wireless-charging-table/model/V1.0/BottomAcrylicPanel.sldprt

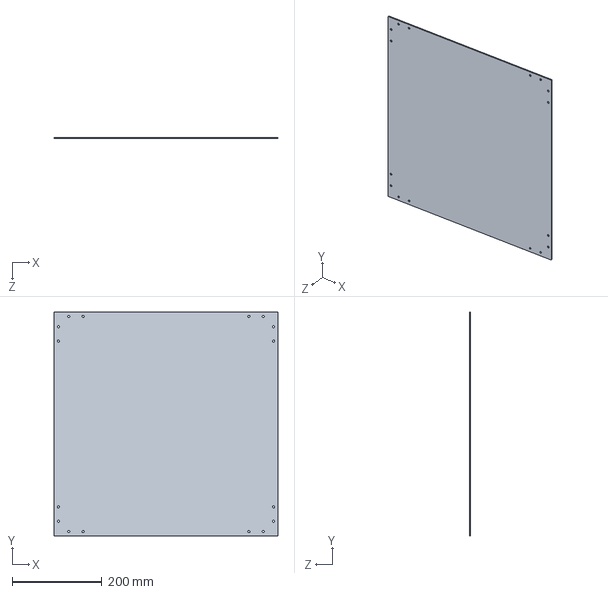
[picture p70: CAD file, 2022-02-23]
model/V1.0/BottomAcrylicPanel.sldprt
500.0 x 500.0 x 3.00 mm
