liuzikai/wireless-charging-table/model/V1.0/ALP2020_300.SLDPRT

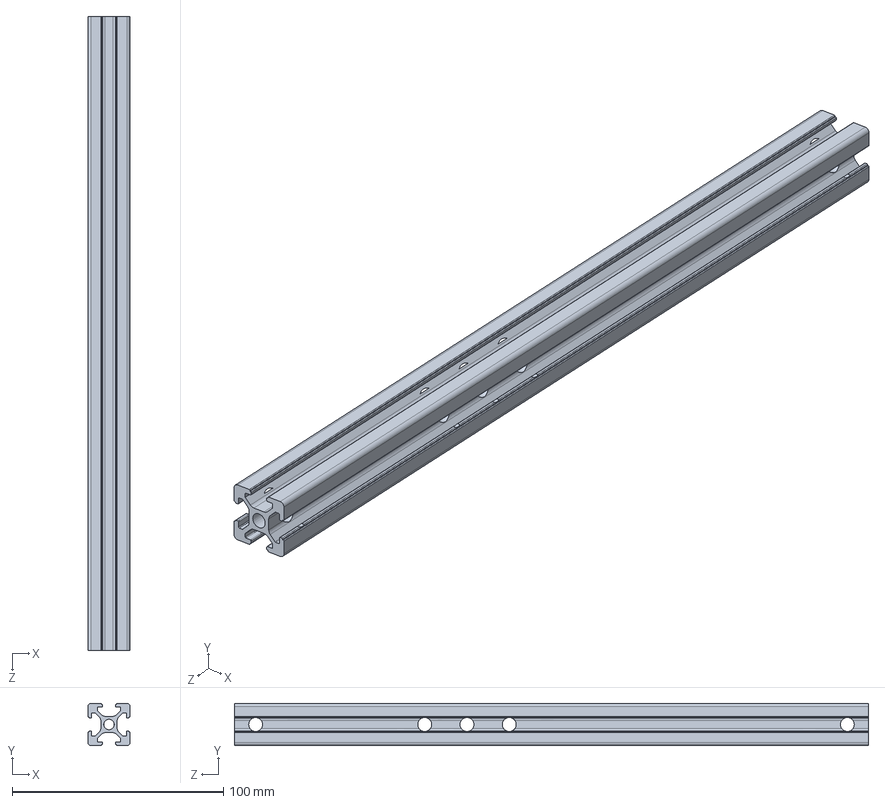
[picture p71: CAD file, 2022-02-23]
model/V1.0/ALP2020_300.SLDPRT
20.0 x 20.0 x 300.0 mm
