liuzikai/wireless-charging-table/model/V1.0/ALP2020_420.SLDPRT

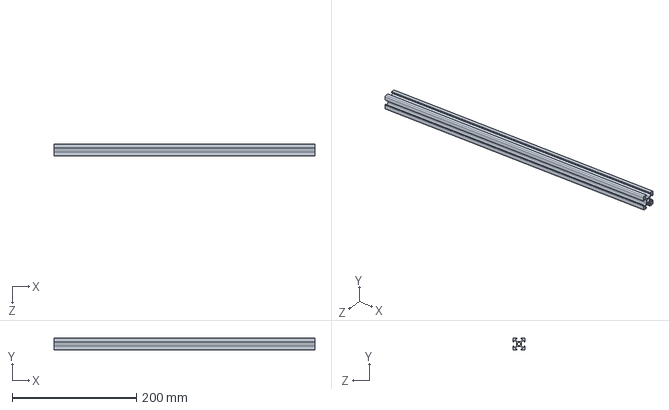
[picture p72: CAD file, 2022-02-23]
model/V1.0/ALP2020_420.SLDPRT
420.0 x 20.0 x 20.0 mm
