liuzikai/wireless-charging-table/model/V1.0/MGN9.SLDPRT

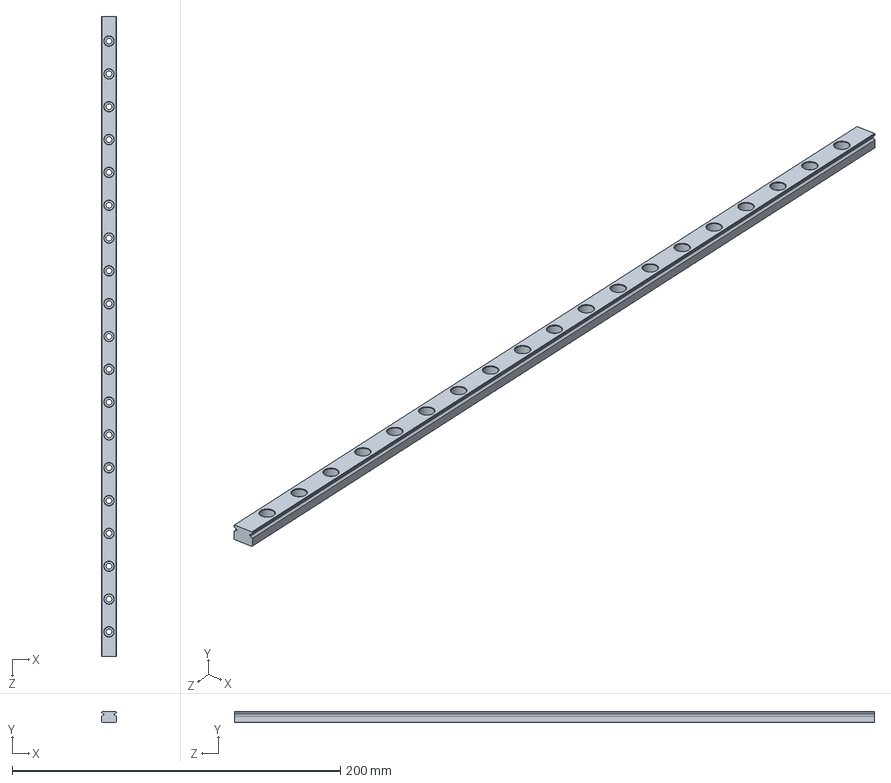
[picture p73: CAD file, 2022-02-23]
model/V1.0/MGN9.SLDPRT
9.00 x 6.50 x 390.0 mm
