liuzikai/wireless-charging-table/model/V1.0/CameraMount.SLDPRT

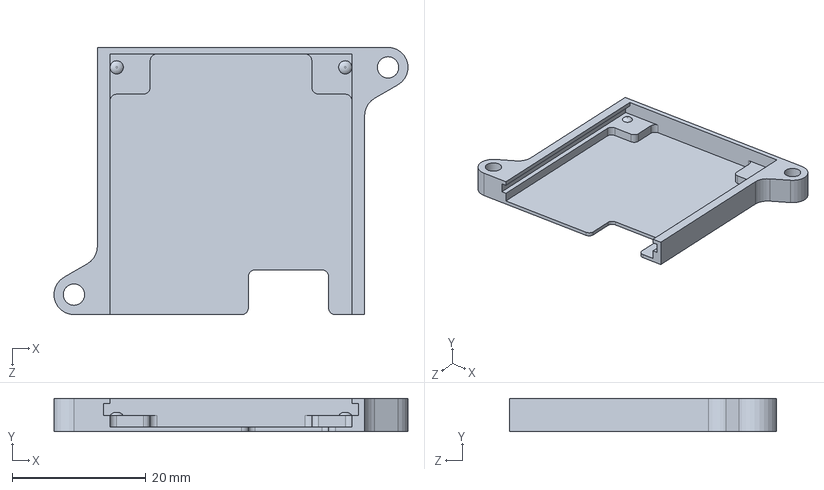
[picture p74: CAD file, 2022-02-23]
model/V1.0/CameraMount.SLDPRT
53.0 x 5.00 x 40.0 mm
