liuzikai/wireless-charging-table/(list of files, cad)

Other CAD files:
model/V1.0/Tensioner A-25^Tensioner A_Front Idler A_Gantry_VORON2 v2.4 Assembly - Final(2)_VORON2 v2.4 Assembly - Final.SLDPRT
model/V1.0/41ME3991AL .stp
model/V1.0/GlassSheet3mm.SLDPRT
model/V1.0/D20L25 Jaw Coupler v5.SLDASM
model/V1.0/M5 1mm Spacer (1)^Idler Assembly (1)_1_XY Joint - Right_X Axis_Gantry_VORON2 v2.4 Assembly - Final(2)_VORON2 v2.4 Assembly - Final.SLDPRT
model/V1.0/MGN9-120.SLDPRT
model/V1.0/MGN9-H.SLDPRT
model/V1.0/T8 nut.SLDPRT
model/V1.0/T8x4 lead screw.ipt
