liuzikai/wireless-charging-table/extra/block-diagram.pdf

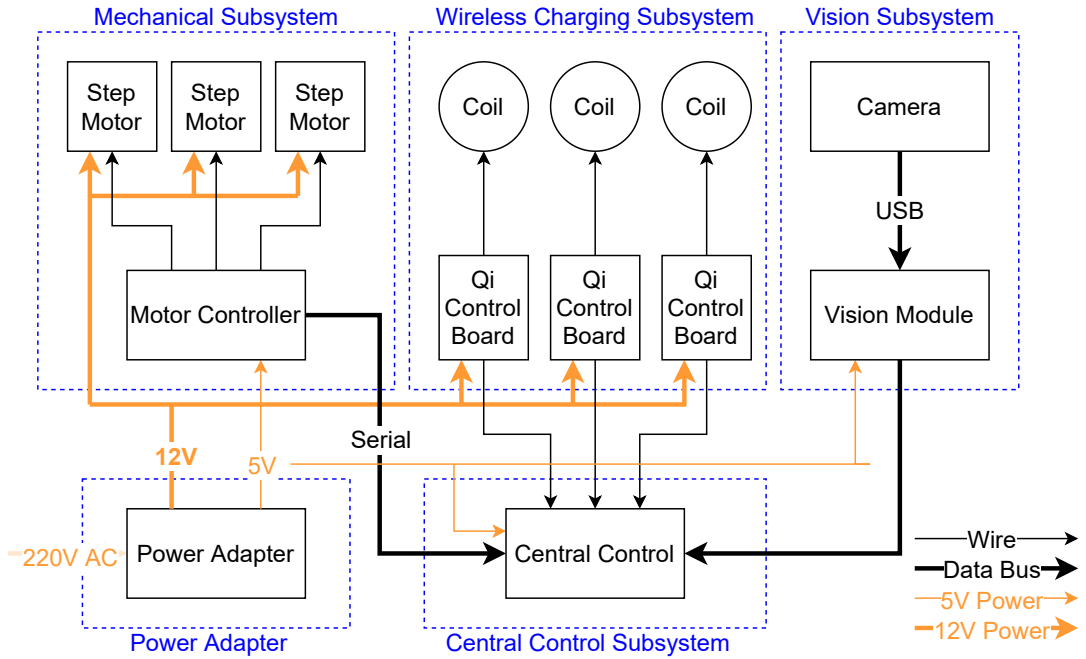
[picture p75: page 1]
Coil; Qi Control Board; Vision Module; USB; Camera; Central Control; Serial; Motor Controller; Step; Motor; Step Motor; Mechanical Subsystem; Wireless Charging Subsystem; Vision Subsystem; Power Adapter; Central Control Subsystem; Wire Data Bus 5V Power 12V Power

220V AC Power Adapter
