liuzikai/wireless-charging-table/include/Common.h

//
// Created by liuzikai on 4/13/21.
//

#ifndef COMMON_H
#define COMMON_H

#include <map>
#include <unordered_map>
#include <set>
#include <unordered_set>
#include <string>
#include <vector>
#include <iostream>

using std::string;
using std::stringstream;
using std::vector;
using std::map;
using std::unordered_map;
using std::set;
using std::unordered_set;

#endif //COMMON_H
