liuzikai/wireless-charging-table/(commit log)

2021-04-05 Some framework
2021-04-06 Save some code for the framework
2021-04-13 fix compile error for vision unit test
    [Camera.h, Common.h, Vision.cpp, main.cpp]
2021-04-13 Submodule JetsonGPIO lib.
2021-04-13 Fix several possible problems in JetsonGPIO.
2021-04-13 Submodule JetsonGPIO lib from new origin.
2021-04-15 update device manager interface
2021-04-15 Update JetsonGPIO lib.
2021-04-15 Write the ChargerManager.
2021-04-15 Add ChargerManagerUnitTest.
2021-04-15 Fix possible problems in JetsonGPIO.
2021-04-22 add gamma correction and refactor the code
    [Common.h, Vision.cpp, Vision.h]
2021-04-24 Simple schedule for non-cover camera
2021-04-24 fix compile error for unit test
    [Vision.cpp, Vision.h, VisionUnitTest.cpp]
2021-04-24 Update GrabberController and ChargerManager.
2021-04-25 add buggy code for distortaion & change return value for vision processing
    [Vision.cpp, Vision.h, VisionUnitTest.cpp, main.cpp]
2021-04-25 Modify device to be Rect. Add exploring
2021-04-25 image calibration & crop done
2021-04-25 Fix when to use Point/Rect
    [Control.cpp, Control.h]
2021-04-27 fix function signature in vision
    [Vision.cpp, Vision.h, VisionUnitTest.cpp]
2021-04-27 fix getting location accuracy
    [Control.cpp, Vision.cpp, Vision.h, VisionUnitTest.cpp]
2021-04-28 Fix the condition for calculating to moving. Fix the strong check that relies on vision
    [Control.cpp]
2021-04-28 Fix the float type assigned to coil position
    [Control.cpp]
2021-04-28 Check for value instead of key for wireless update
2021-05-14 Extend ChargerManager to 3 coils.
2021-05-14 Add the init position for 3 coils. Add collision checking
    [Control.cpp, Control.h]
2021-05-14 fix the delay for fetching coil
    [Control.cpp, GrabberController.cpp, GrabberController.h]
2021-05-15 Revert JetsonGPIO submodule to the upstream one.
2022-02-23 [Hw] CAD model upload.
    [41ME3991AL .stp, A Drive Frame-23^A Drive Frame_A Drive_Gantry_VORON2 v2.4 Assembly - Final(2)_VORON2 v2.4 Assembly - Final.SLDPRT, A Drive Frame-24^A Drive Frame_A Drive_Gantry_VORON2 v2.4 Assembly - Final(2)_VORON2 v2.4 Assembly - Final.SLDPRT, ALP2020_300.SLDPRT, ALP2020_330.SLDPRT, ALP2020_420.SLDPRT, ALP2020_460.SLDPRT, B Drive Frame (1)^B Drive_Gantry_VORON2 v2.4 Assembly - Final(2)_VORON2 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]
